spenceraxani/Desktop-Muon-Detector/Pictures/6.jpg

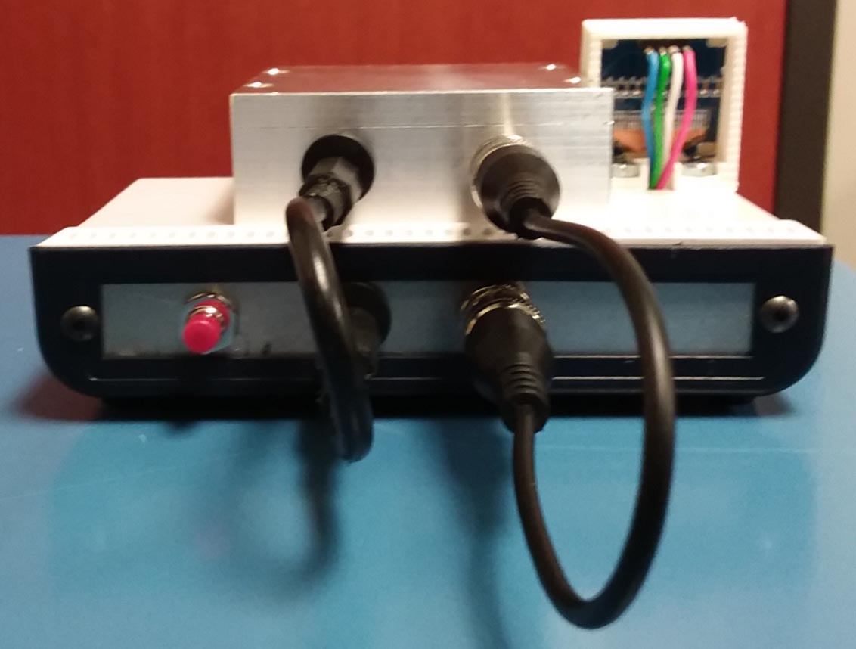
Pictures/6.jpg
