spenceraxani/Desktop-Muon-Detector/Pictures/pcb.jpg

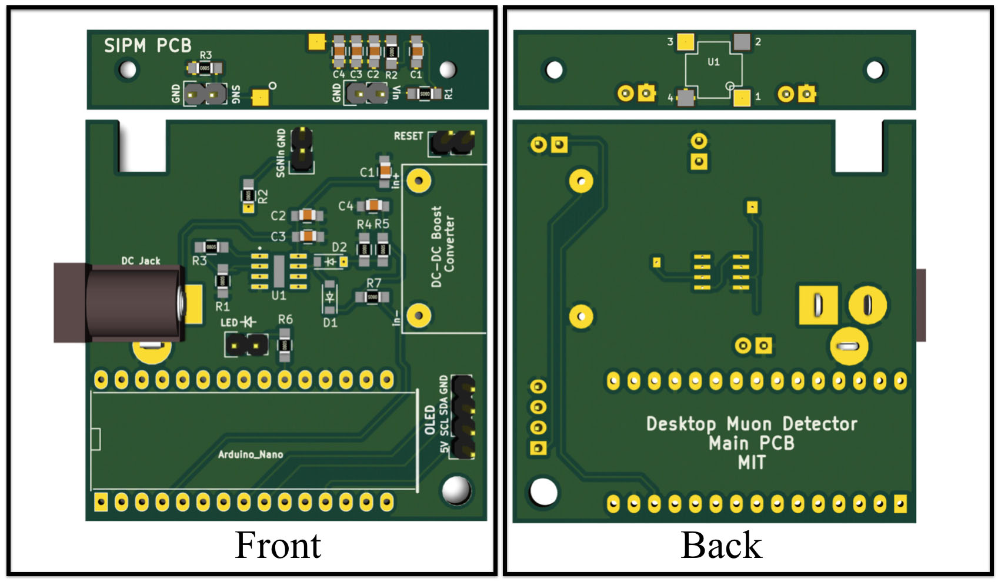
Pictures/pcb.jpg
