spenceraxani/Desktop-Muon-Detector/README.md

# Desktop Muon Detector
-- OUTDATED -- 

Please use the updated detector repository here:

[https://github.com/spenceraxani/CosmicWatch-Desktop-Muon-Detector-v3X]

The supplementary material for the Desktop Muon Detector --
ArXiv article: arXiv:1606.01196 [physics.ed-ph]

-- OUTDATED --
