spenceraxani/Desktop-Muon-Detector/Pictures/1.jpg

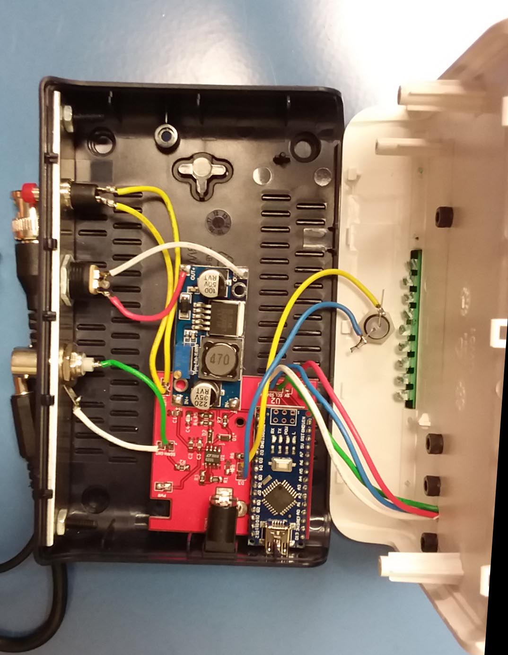
Pictures/1.jpg
