spenceraxani/Desktop-Muon-Detector/Pictures/2.jpg

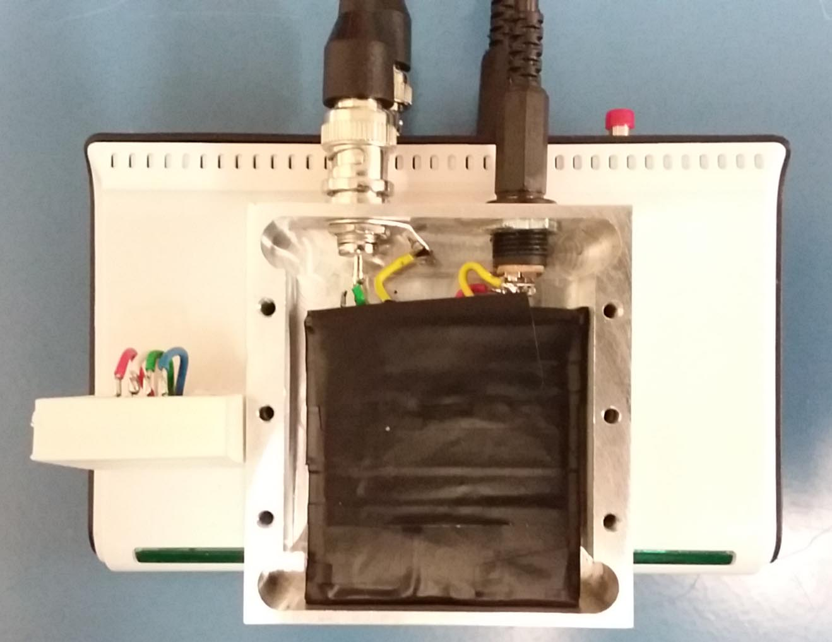
Pictures/2.jpg
