spenceraxani/Desktop-Muon-Detector/Pictures/3.jpg

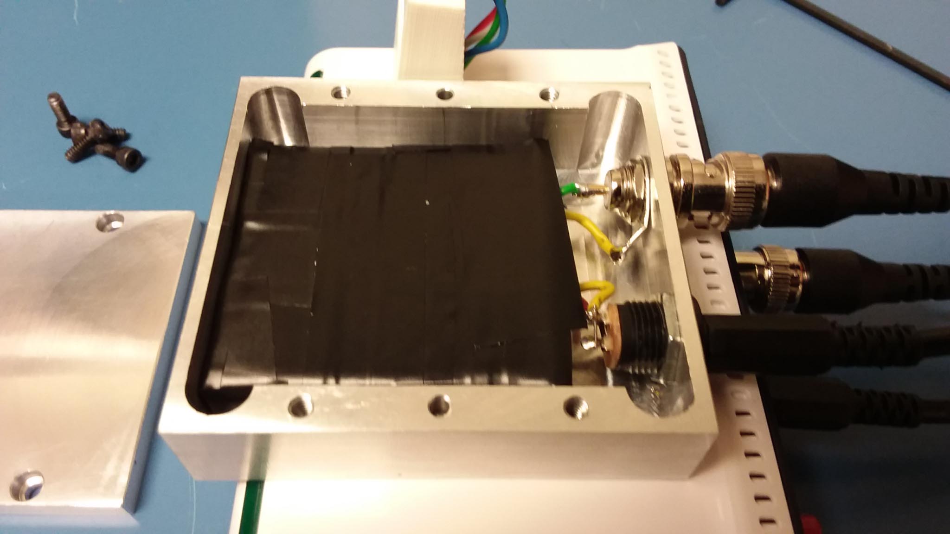
Pictures/3.jpg
