spenceraxani/Desktop-Muon-Detector/Pictures/4.jpg

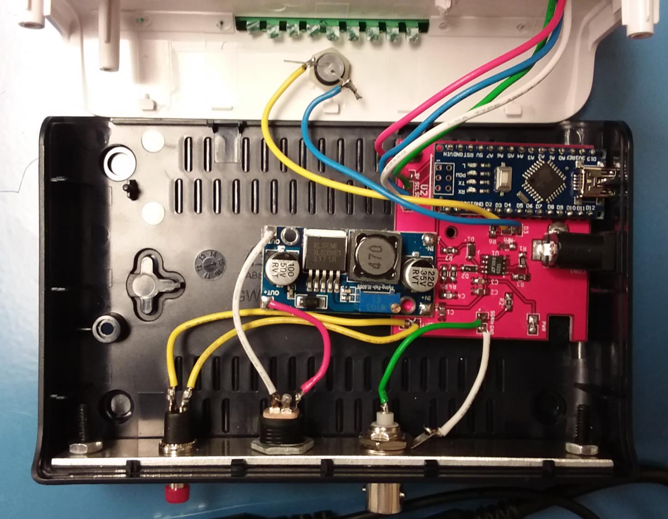
Pictures/4.jpg
