spenceraxani/Desktop-Muon-Detector/Pictures/5.jpg

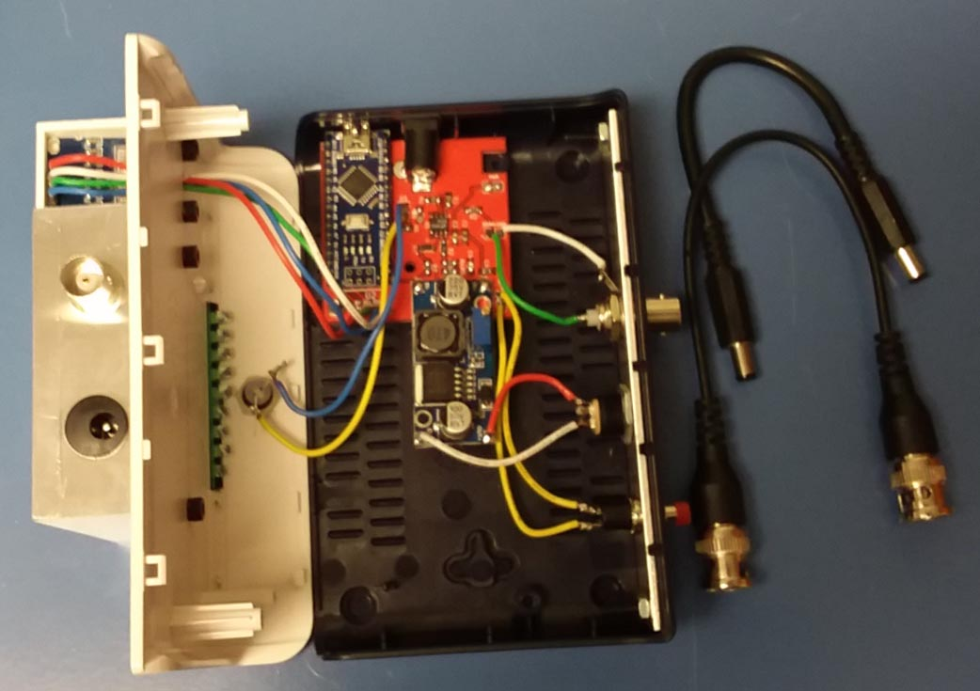
Pictures/5.jpg
