spenceraxani/Desktop-Muon-Detector/Pictures/7.jpg

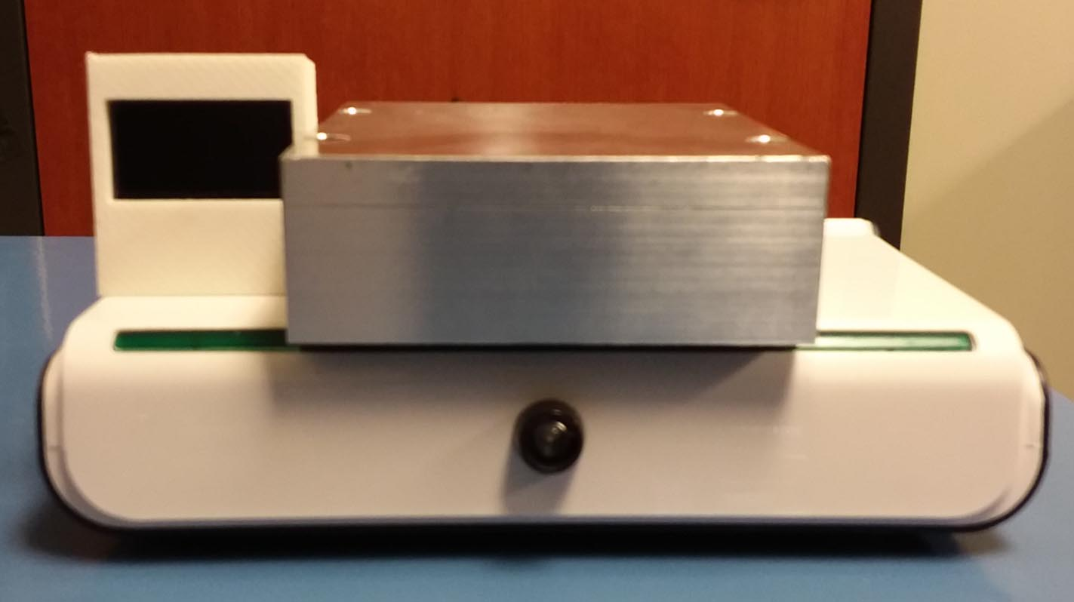
Pictures/7.jpg
