spenceraxani/Desktop-Muon-Detector/Pictures/8.jpg

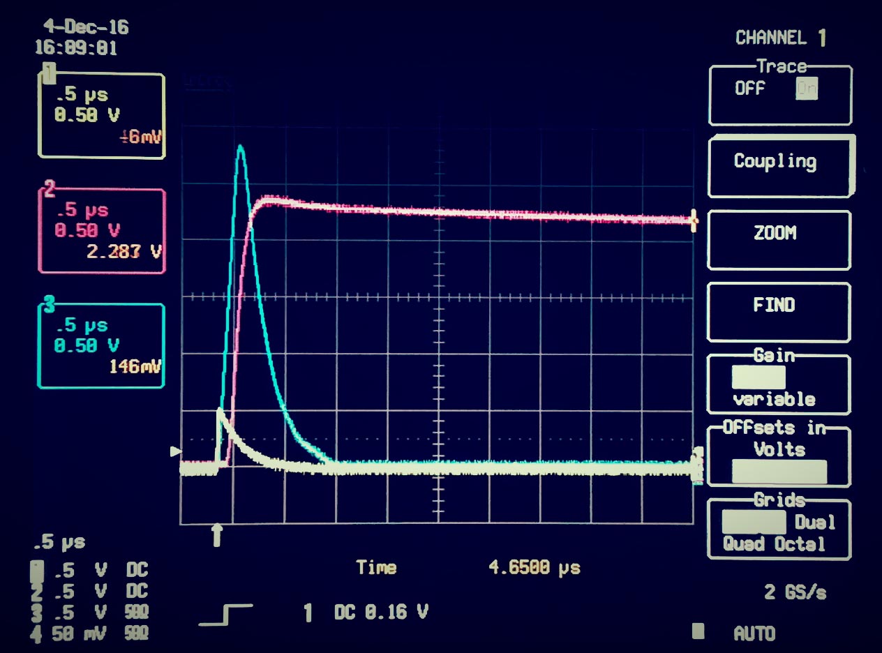
Pictures/8.jpg
