spenceraxani/Desktop-Muon-Detector/Pictures/b.jpg

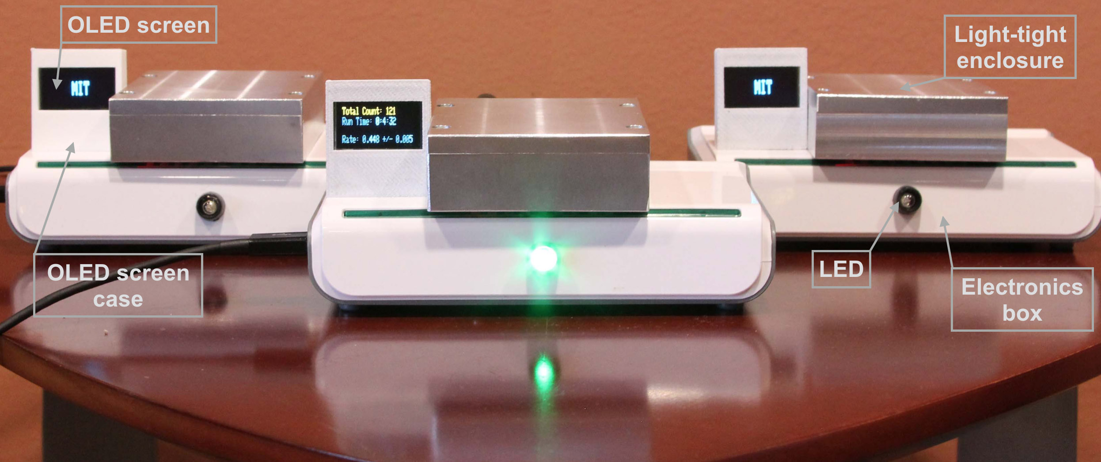
Pictures/b.jpg
