spenceraxani/Desktop-Muon-Detector/Pictures/backplate.jpg

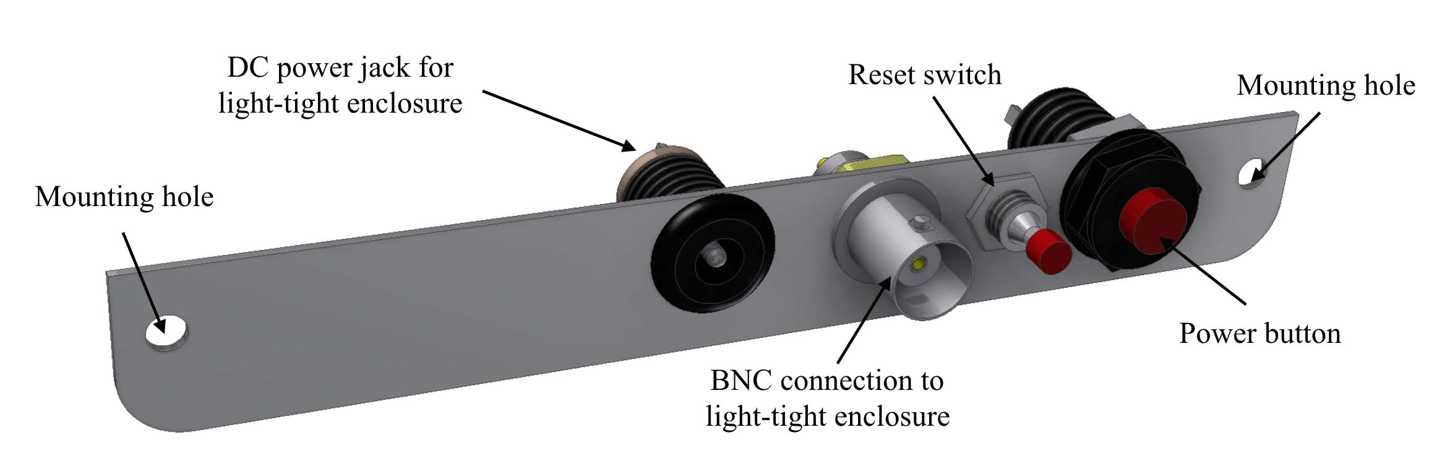
Pictures/backplate.jpg
