spenceraxani/Desktop-Muon-Detector/Pictures/box.jpg

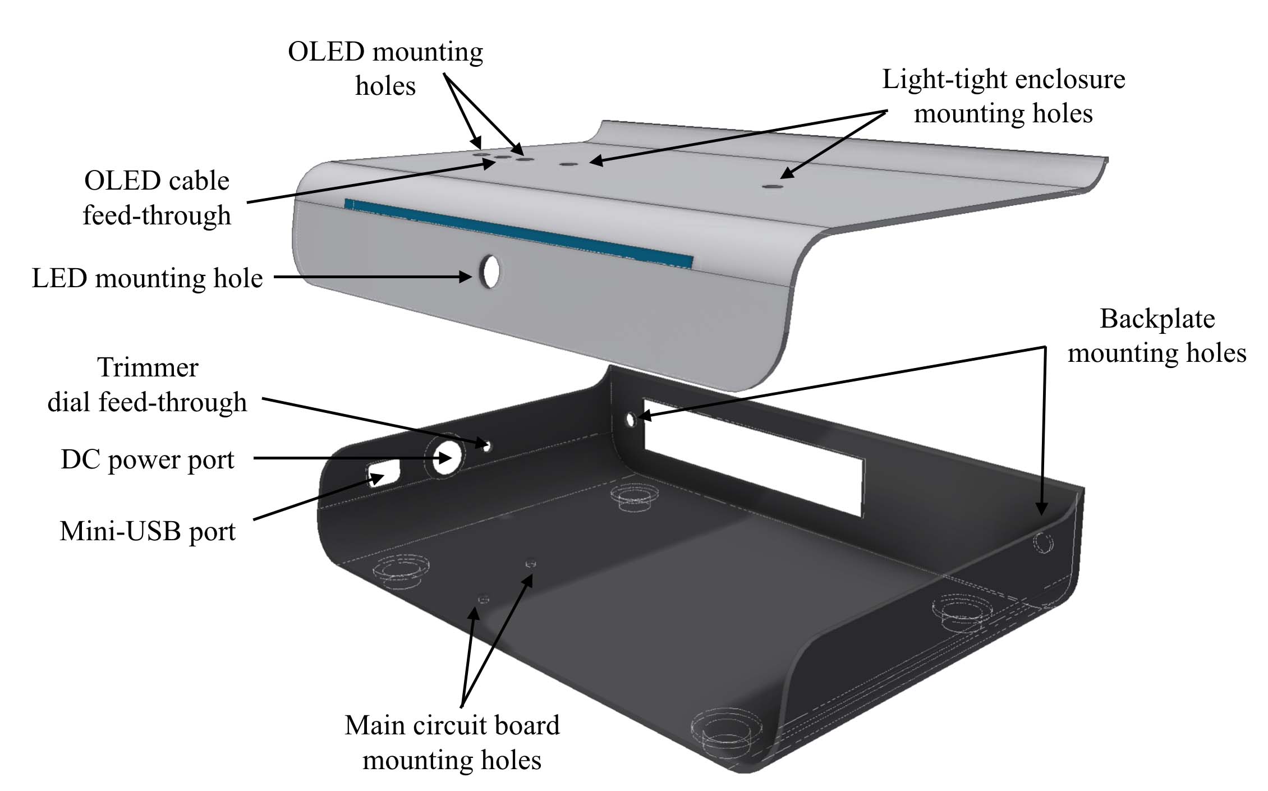
Pictures/box.jpg
