spenceraxani/Desktop-Muon-Detector/Pictures/circuit.png

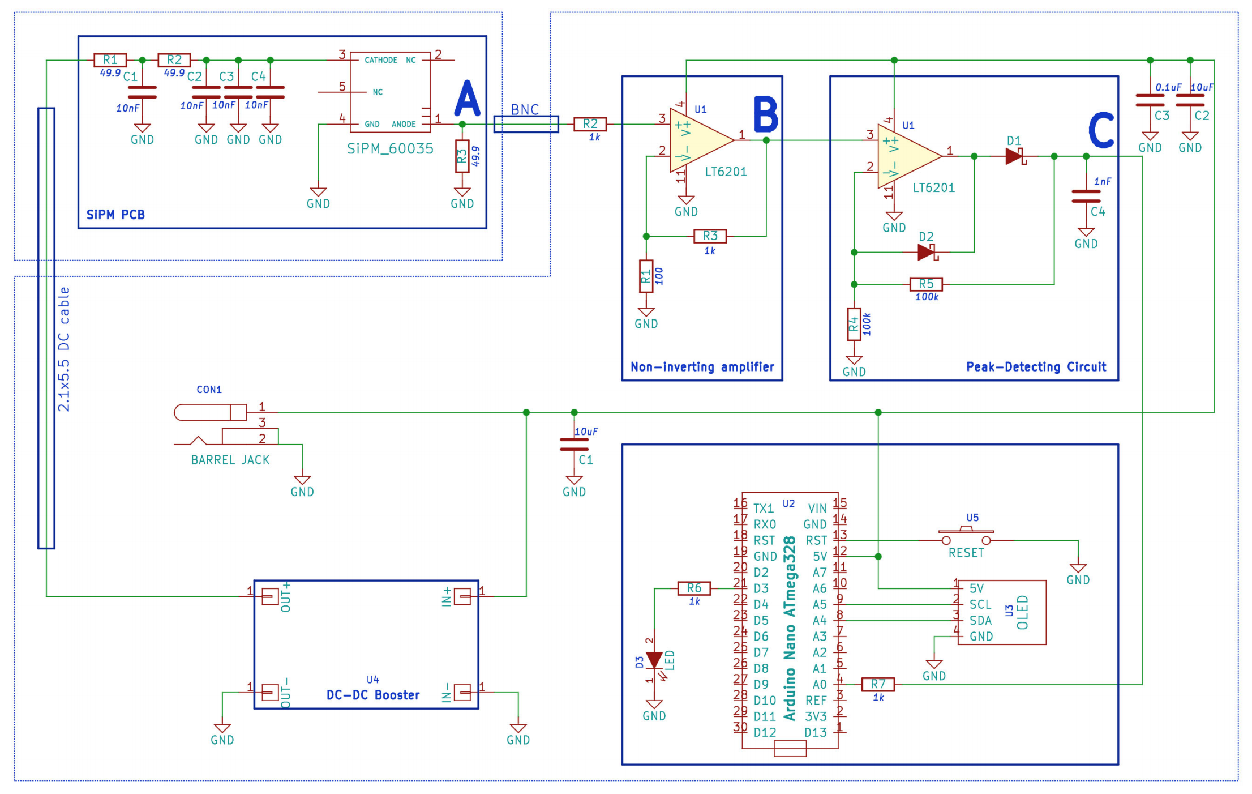
Pictures/circuit.png
