spenceraxani/Desktop-Muon-Detector/Pictures/coincidence.png

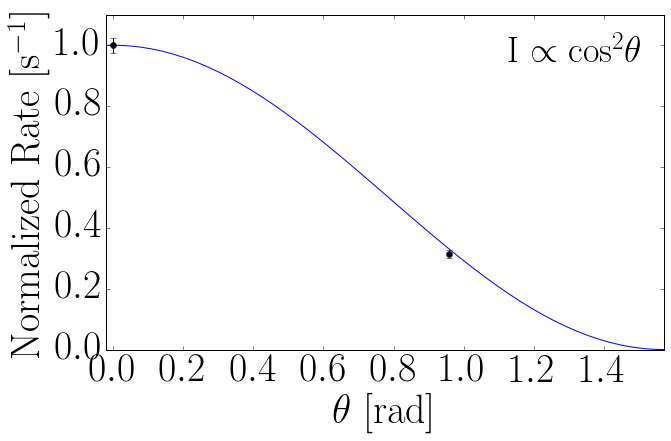
Pictures/coincidence.png
