spenceraxani/Desktop-Muon-Detector/Pictures/data_plot.jpg

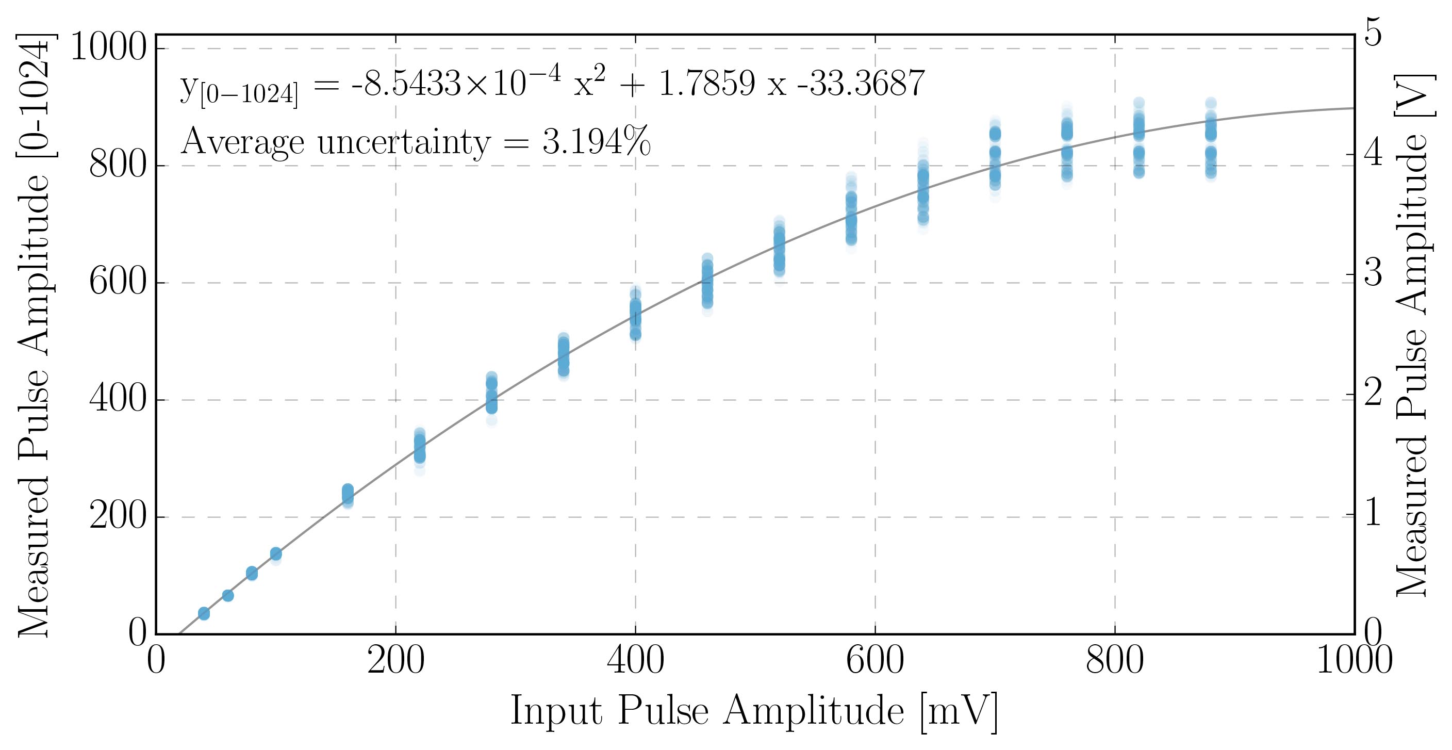
Pictures/data_plot.jpg
