spenceraxani/Desktop-Muon-Detector/Pictures/flight.jpg

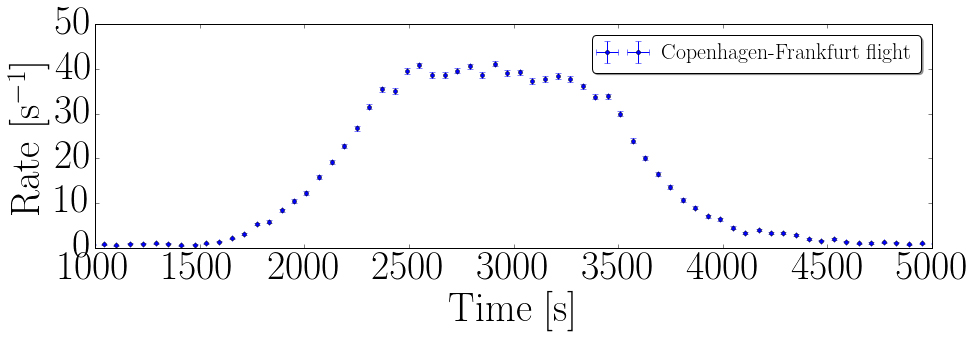
Pictures/flight.jpg
