spenceraxani/Desktop-Muon-Detector/Pictures/full_circuit.jpg

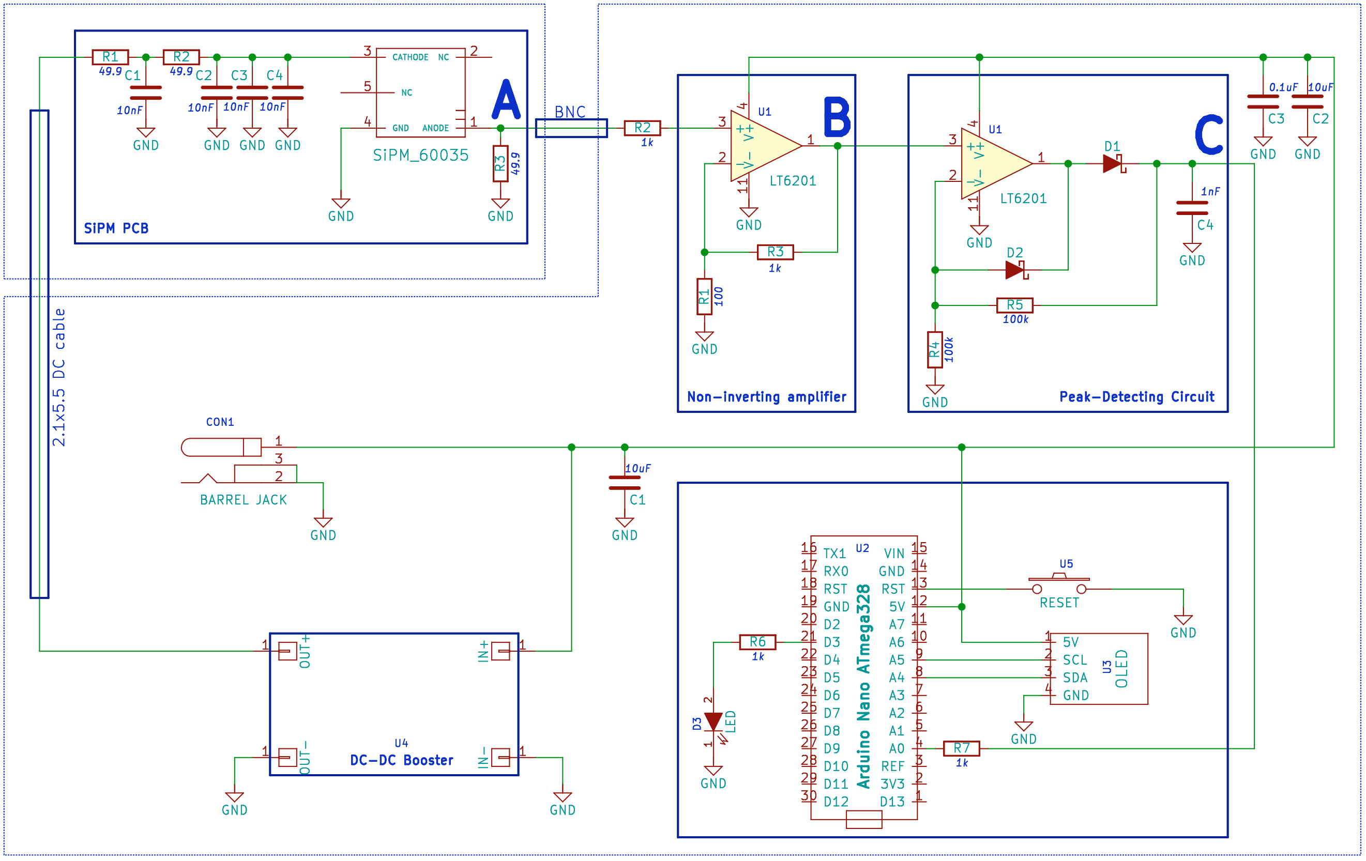
Pictures/full_circuit.jpg
