spenceraxani/Desktop-Muon-Detector/Pictures/light_tight_enclosure.jpg

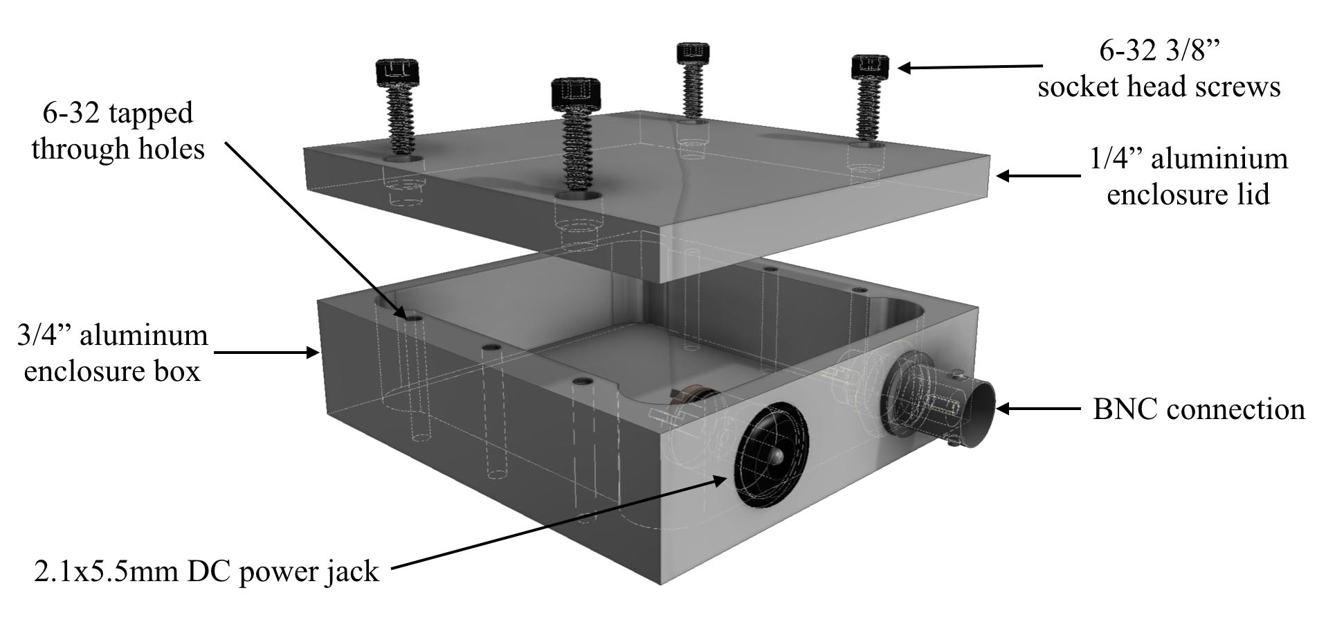
Pictures/light_tight_enclosure.jpg
