spenceraxani/Desktop-Muon-Detector/Pictures/lowPass.jpg

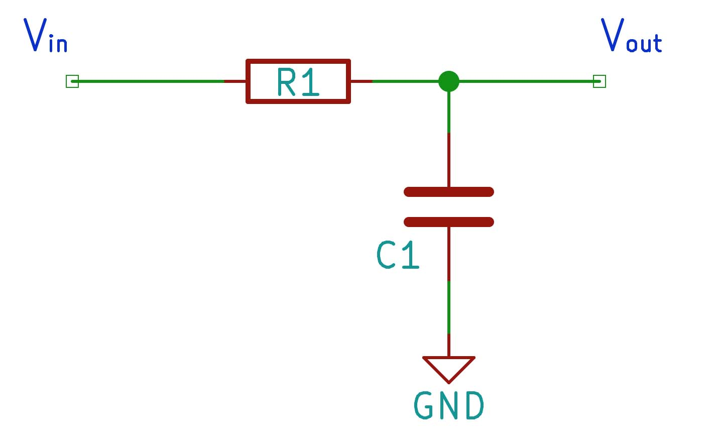
Pictures/lowPass.jpg
