spenceraxani/Desktop-Muon-Detector/Pictures/NIamp.jpg

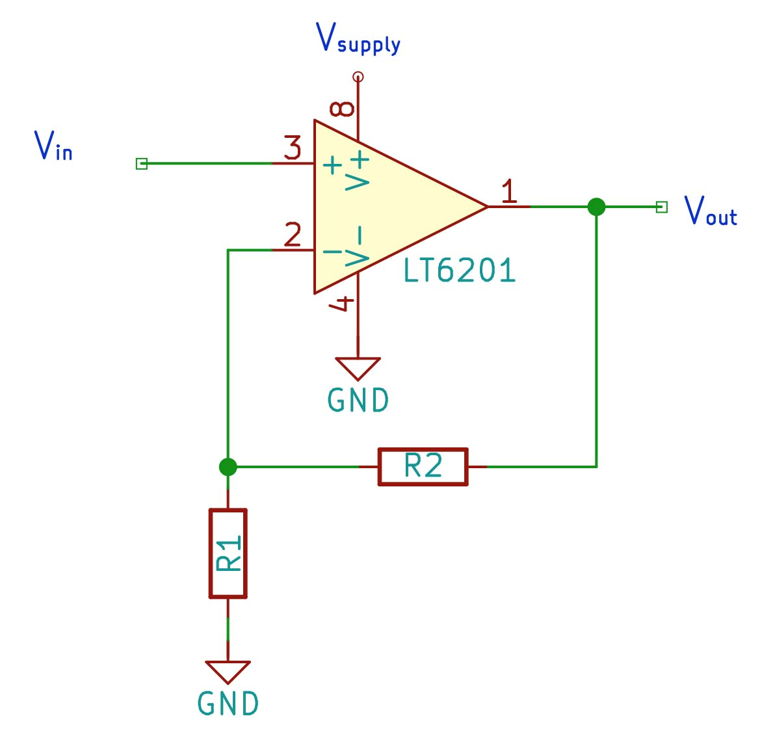
Pictures/NIamp.jpg
