spenceraxani/Desktop-Muon-Detector/Pictures/oled.jpg

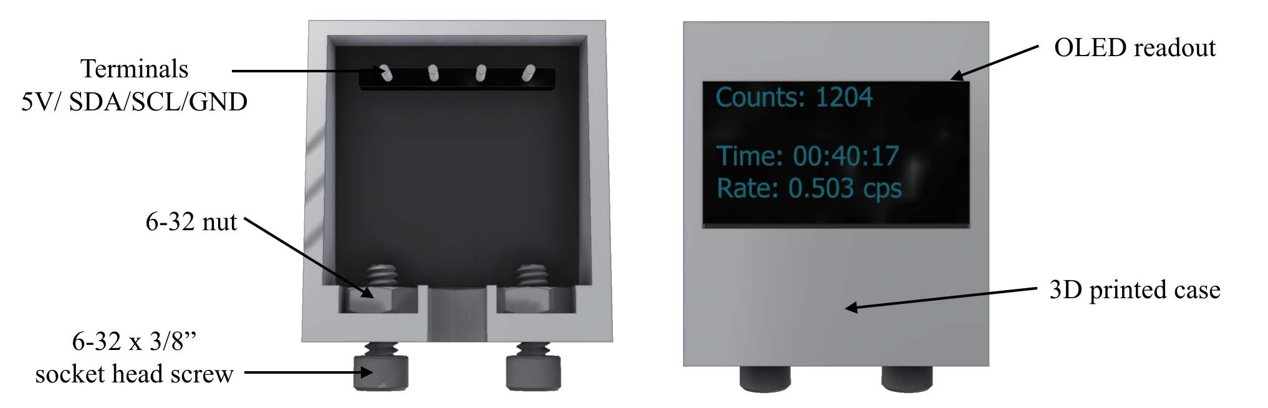
Pictures/oled.jpg
