spenceraxani/Desktop-Muon-Detector/Pictures/osc2.jpg

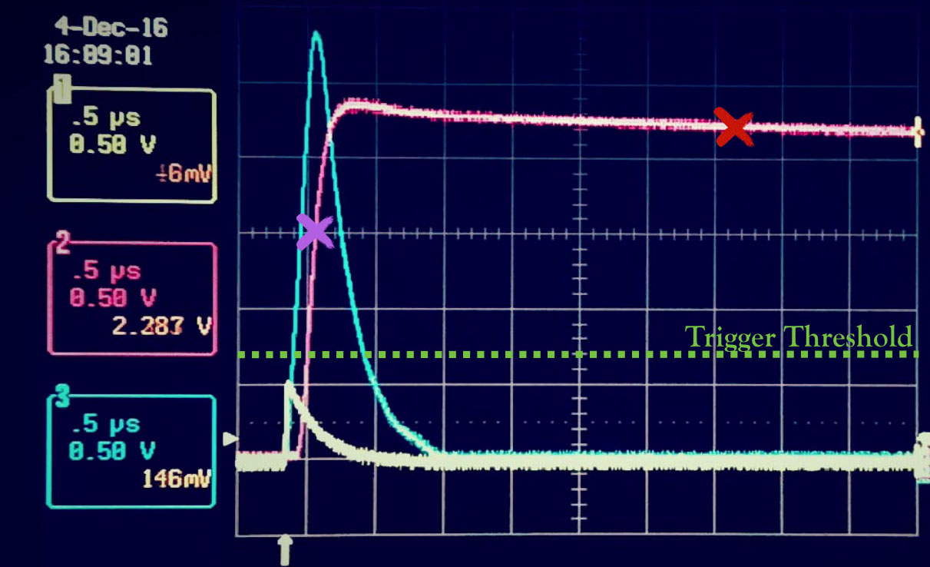
Pictures/osc2.jpg
