spenceraxani/Desktop-Muon-Detector/Pictures/osc.jpg

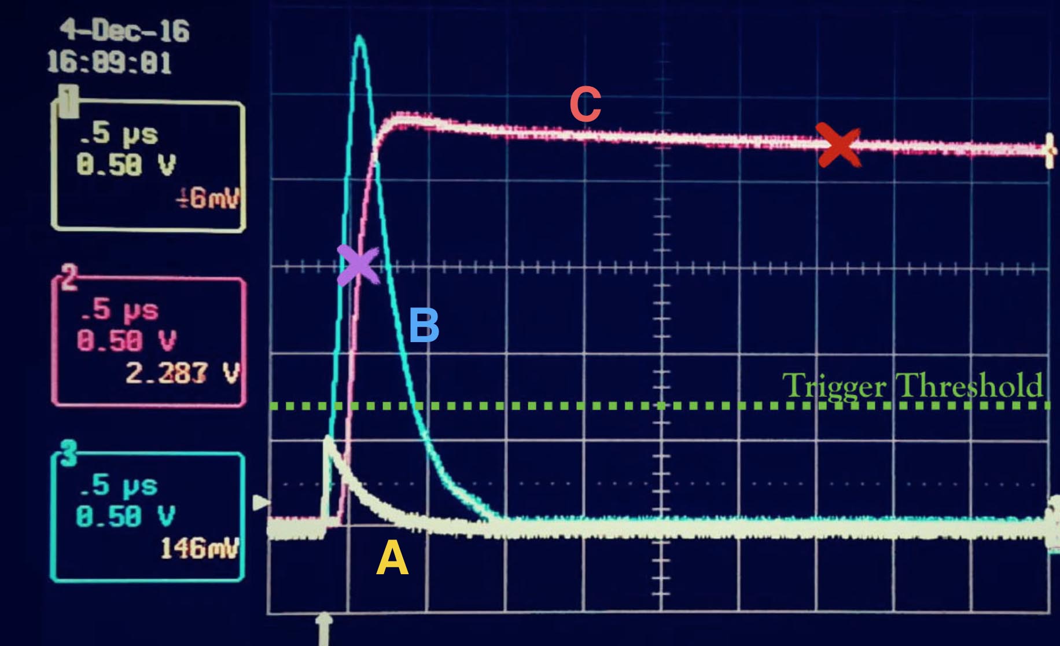
Pictures/osc.jpg
