spenceraxani/Desktop-Muon-Detector/Pictures/pcb.png

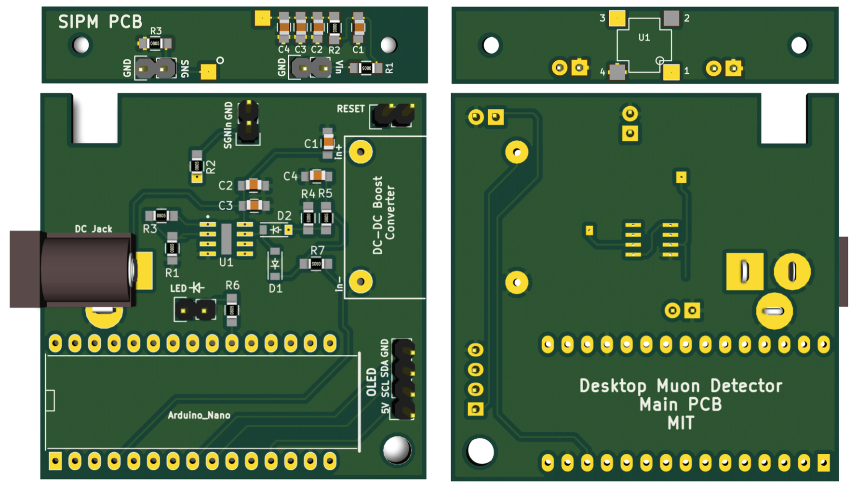
Pictures/pcb.png
