spenceraxani/Desktop-Muon-Detector/Pictures/peakd.jpg

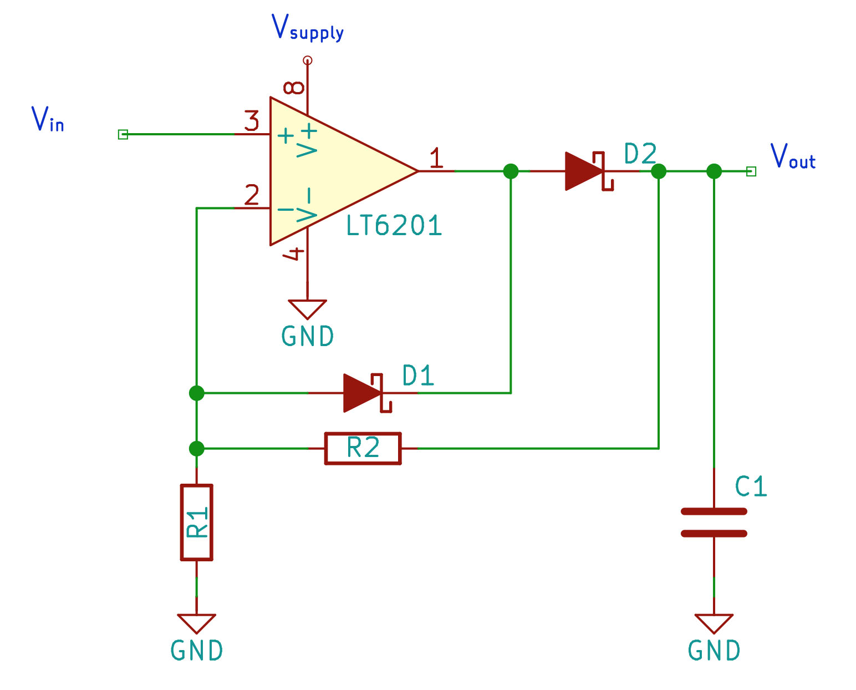
Pictures/peakd.jpg
