spenceraxani/Desktop-Muon-Detector/Pictures/rate.jpg

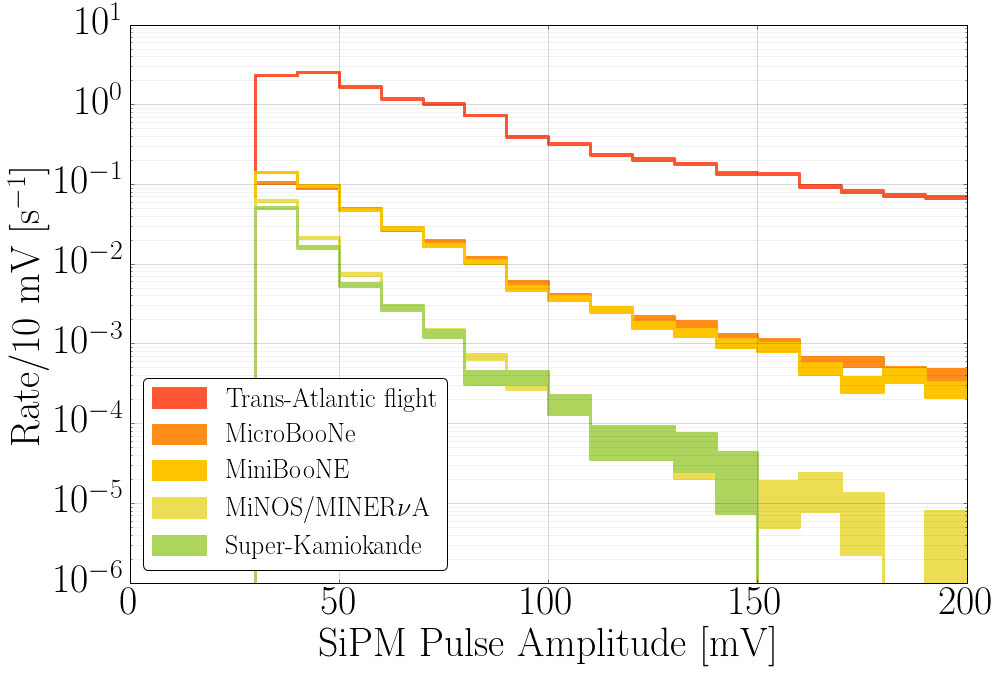
Pictures/rate.jpg
