spenceraxani/Desktop-Muon-Detector/Pictures/SiPM_PS.png

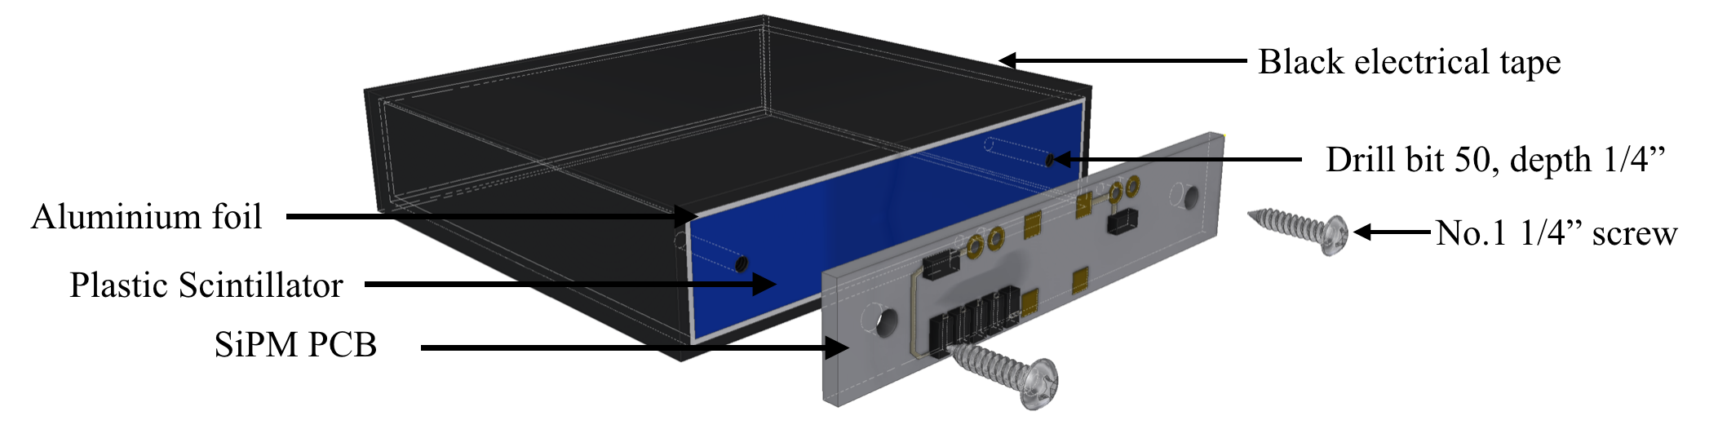
Pictures/SiPM_PS.png
