spenceraxani/Desktop-Muon-Detector/Purchasing_list.xlsx

Component List
No | Description | Required Quantity | Manufacturer | Part Number | Vendor | Purchase Quantity | Unit Price | Price | Website link
Main Components
1 | (SiPM) SensL 60035 smt C-series | 1 | SensL |  | SensL | 100 | 48.00 | 48.00 | http://sensl.com/estore/microfc-60035-smt/
2 | (Electronics Case) Tenda S105 5-Port 10/100Mbps Fast Ethernet Switch + 5V power supply | 1 | Tenda | S105 | Amazon | 1 | 9.16 | 9.16 | http://www.amazon.com/Tenda-S105-Unmanaged-100Mbps-Ethernet/dp/B006KAP55E
3 | (OLED screen) 0.96" Yellow& Blue 128X64 OLED I2C IIC Serial LCD | 1 | DIYmall |  | Amazon | 1 | 3.69 | 3.69 | http://www.ebay.com/itm/0-96-Yellow-Blue-128X64-OLED-I2C-IIC-Serial-LCD-LED-Display-Module-for-Arduino-B3:K45-jhUK-o~
4 | 6-32x3/8" socket head screws | 10 | McMaster Carr |  | McMaster Carr | 100 | 0.08 | 0.84 | http://www.mcmaster.com/#socket-head-cap-screws/=12e48qv
5 | 6-32 nuts | 2 | McMaster Carr |  | McMaster Carr | 100 | 0.05 | 0.10 | http://www.mcmaster.com/#hex-nuts/=12e49wo
6 | BNC Female Nut Bulkhead Solder RF Connector | 2 | Bluecell | 5316345 | Amazon | 1 | 1.47 | 2.94 | http://www.amazon.com/Bluecell-Female-Bulkhead-Connector-Adapters/dp/B00QPWBNXU
7 | Reset switch | 1 | URBEST |  | Amazon | 10 | 0.70 | 0.70 | http://www.amazon.com/URBEST%C2%AE10-Round-Momentary-Botton-Switch/dp/B00OJZPMD2?redirect=true
8 | Female 5.5mmx2.1mm DC Power Jack | 1 |  |  | Amazon | 50 | 0.11 | 0.11 | http://www.amazon.com/50PCS-5-5mmx2-1mm-3Pins-Mounting-Female/dp/B00MJVIFS2?redirect=true
9 | 2.1x5.5mm DC Power Jack Socket | 2 |  |  | Amazon | 50 | 0.28 | 0.55 | http://www.amazon.com/50Pcs-2-1x5-5mm-Socket-Mounting-Earphones/dp/B00H8S4H9W?redirect=true
10 | USB 2.0 Type A to Mini-B Cable (often supplied with Arduino) | 1 |  |  | ebay | 3 | 0.77 | 0.77 | http://www.ebay.com/itm/New-Black-USB-2-0-A-Male-to-Mini-5-Pin-B-Data-Charging-Cable-Cord-Adapter-/191690598969
11 | SiPM PCB (manufacturing cost) | 1 | Elecrow.com | SiPM_PCB.zip | Elecrow | 10 | 0.99 | 0.99 | http://www.elecrow.com/services-c-73.html
12 | Main PCB (manufacturing cost) | 1 | Elecrow.com | Main_PCB.zip | Elecrow | 10 | 0.99 | 0.99 | http://www.elecrow.com/services-c-73.html
13 | 3/4" aluminium plate (2.75"x3.0"x3/4") | 1 | McMaster Carr |  | McMaster Carr | 3"x24"x3/4" | 4.52 | 4.52 | http://www.mcmaster.com/#standard-aluminum-plates/=13kanb3
14 | 1/4" aluminium plate (~2.75"x3.00"x1/4") | 1 | McMaster Carr |  | McMaster Carr | 3"x24"x1/4" | 2.36 | 2.36 | http://www.mcmaster.com/#standard-aluminum-plates/=13kan4b
15 | 3D-printed screen protector, 0.5"^3 material | 1 |  |  |  |  | 5.00 | 5.00
Electronic Components
16 | Dual Op-amp RRIO 165 MHz | 1 | Linear Technology | LT6201CS8#PBF-ND | Linear Technology | 1 | 4.50 | 4.50 | http://www.linear.com/product/LT6201
17 | Arduino Nano (often will come with a mini-usb cable) | 1 |  |  | ebay | 1 | 1.89 | 1.89 | http://www.ebay.com/itm/Mini-USB-Nano-V3-0-ATmega328-CH340G-5V-16M-Micro-controller-board-for-Arduino-/271675478151
18 | DC-DC Boost Converter, 400kHz switching frequency | 1 | Yankee Electronics |  | ebay | 1.35 | 1.35 | 1.35 | http://www.ebay.com/itm/DC-DC-Adjustable-Step-up-boost-Power-Converter-Module-XL6009-Replace-LM2577-/371054648639
19 | 40V Schottky diode | 2 | digikey | MBR0540CT-ND | Digikey | 100 | 0.14 | 0.28 | http://www.digikey.com/scripts/DkSearch/dksus.dll?Detail&itemSeq=202968032&uq=636054679578129175
20 | (0805) 1K 1% 1/8W | 4 | digikey | 311-1.00KCRCT-ND (http://www.digikey.com/scripts/DkSearch/dksus.dll?Detail&itemSeq=202966236&uq=636054677712469041) | Digikey | 100 | 0.01 | 0.03 | http://www.digikey.com/product-detail/en/stackpole-electronics-inc/RMCF0805JT10K0/RMCF0805JT10K0CT-ND/1942577
21 | (0805)100 1% 1/8W | 1 | digikey | 311-100CRDKR-ND (https://www.digikey.com/product-detail/en/yageo/RC0805FR-07100RL/311-100CRDKR-ND/733437) | DigiKey | 100 | 0.01 | 0.01 | https://www.digikey.com/product-detail/en/yageo/RC0805FR-07100RL/311-100CRDKR-ND/733437
22 | (0805) 100K 1% 1/8W | 2 | digikey | 311-100KCRCT-ND | Digikey | 100 | 0.01 | 0.02 | http://www.digikey.com/scripts/DkSearch/dksus.dll?Detail&itemSeq=202966511&uq=636054679578099184
23 | (0805) 1nF 50V SMT cap | 1 | digikey | 399-1147-1-ND | Digikey | 100.00 | 0.02 | 0.02 | http://www.digikey.com/product-detail/en/kemet/C0805C102K5RACTU/399-1147-1-ND/411422
24 | (0805) 10uF CER 35V capacitor | 2 | digikey | 490-9964-1-ND (http://www.digikey.com/product-detail/en/murata-electronics-north-america/GRM319R6YA106KA12D/490-9964-1-ND/5026458) | Digikey | 25 | 0.14 | 0.28 | http://www.digikey.com/product-detail/en/murata-electronics-north-america/GRM319R6YA106KA12D/490-9964-1-ND/5026458
25 | (0805) 10nF 50V SMT cap | 4 | digikey | 311-1136-1-ND | amazon | 100 | 0.01 | 0.06 | http://www.digikey.com/scripts/DkSearch/dksus.dll?Detail&itemSeq=202967660&uq=636054697441185813
26 | (0805) 49.9 Ohm 1% 1/8W | 3 | digikey | P49.9CCT-ND | Digikey | 100 | 0.02 | 0.05 | http://www.digikey.com/product-detail/en/panasonic-electronic-components/ERJ-6ENF49R9V/P49.9CCT-ND/118581
27 | (0805) 0.1uF 50V SMT cap | 1 | digikey | 1276-1007-1-ND | Digikey | 100.00 | 0.01 | 0.01 | http://www.digikey.com/product-detail/en/samsung-electro-mechanics-america-inc/CL21F104ZBCNNNC/1276-1007-1-ND/3889093
 |  |  |  |  |  |  | Total: | 89.22 | USD
Other Potential Components/Tools
33 | ~22 gauge wire
34 | solder
35 | soldering iron
36 | fine tip tweezers
37 | Mill+milling tools
40 | BNC cable (may have to make your own)
