spenceraxani/Desktop-Muon-Detector/PCB/SMT_reference.xlsx

Main PCB
Component | value | Description | Link
R1 | 100 | 0805 1% 1/8W | 311-100CRCT-ND (http://www.digikey.com/product-detail/en/yageo/RC0805FR-07100RL/311-100CRCT-ND/730490) | Digikey Part: 311-100CRCT-ND
R2 | 1k | 0805 1% 1/8W | 311-1.00KCRCT-ND (http://www.digikey.com/product-detail/en/yageo/RC0805FR-071KL/311-1.00KCRCT-ND/730391) | Digikey Part: 311-1.00KCRCT-ND
R3 | 1k | 0805 1% 1/8W | 311-1.00KCRCT-ND (http://www.digikey.com/product-detail/en/yageo/RC0805FR-071KL/311-1.00KCRCT-ND/730391) | Digikey Part: 311-1.00KCRCT-ND
R4 | 100k | 0805 1% 1/8W | 311-100KCRCT-ND (http://www.digikey.com/product-detail/en/yageo/RC0805FR-07100KL/311-100KCRCT-ND/730491) | Digikey Part: 311-100KCRCT-ND
R5 | 100k | 0805 1% 1/8W | 311-100KCRCT-ND (http://www.digikey.com/product-detail/en/yageo/RC0805FR-07100KL/311-100KCRCT-ND/730491) | Digikey Part: 311-100KCRCT-ND
R6 | 1k | 0805 1% 1/8W | 311-1.00KCRCT-ND (http://www.digikey.com/product-detail/en/yageo/RC0805FR-071KL/311-1.00KCRCT-ND/730391) | Digikey Part: 311-1.00KCRCT-ND
R7 | 1k | 0805 1% 1/8W | 311-1.00KCRCT-ND (http://www.digikey.com/product-detail/en/yageo/RC0805FR-071KL/311-1.00KCRCT-ND/730391) | Digikey Part: 311-1.00KCRCT-ND
C1 | 10uF | CER 35V 0805 | 490-9964-1-ND (http://www.digikey.com/scripts/DkSearch/dksus.dll?Detail&itemSeq=203015473&uq=636054677712509029) | Digikey Part: 490-9964-1-ND
C2 | 10uF | CER 35V 0805 | 490-9964-1-ND (http://www.digikey.com/scripts/DkSearch/dksus.dll?Detail&itemSeq=203015473&uq=636054677712509029) | Digikey Part: 490-9964-1-ND
C3 | 0.1uF | CER 50V Y5V 0805 | 1276-1007-1-ND (http://www.digikey.com/scripts/DkSearch/dksus.dll?Detail&itemSeq=202967692&uq=636054679578129175) | Digikey Part: 1276-1007-1-ND
C4 | 1nF | CER 50V X7R 0805 | 399-1147-1-ND (http://www.digikey.com/scripts/DkSearch/dksus.dll?Detail&itemSeq=202967660&uq=636054679578119178) | Digikey Part: 399-1147-1-ND
D1 |  | Schottky 40V 500MA | MBR0540CT-ND (https://www.digikey.com/products/en?keywords=MBR0540CT-ND) | Digikey Part: 490-9964-1-ND
D2 |  | Schottky 40V 500MA | MBR0540CT-ND (https://www.digikey.com/products/en?keywords=MBR0540CT-ND) | Digikey Part: 490-9964-1-ND
D3 | 5mm | LED | ArduinoLink (https://www.amazon.com/s?url=search-alias%3Daps&field-keywords=led+5mm&rh=i%3Aaps%2Ck%3Aled+5mm)
U1 | 165 MHz | Dual Op-Amp LT6201CS8 | LT6201CS8#PBF-ND (http://www.digikey.com/product-detail/en/linear-technology/LT6201CS8-PBF/LT6201CS8-PBF-ND/888717)
U2 | 16 MHz | 16 MHz Arduino Nano | ArduinoLink (https://www.arduino.cc/en/Main/ArduinoBoardNano) | Check Ebay
U3 |  | OLED 0.96" screen | AmazonLink (https://www.amazon.com/Diymall%C2%AE-Yellow-Serial-Arduino-Display/dp/B00O2LLT30) | Check Ebay
U4 | 30V | DC-DC Boost Converter | AmazonLink (https://www.amazon.com/Hilitchi-LM2596-Converter-XL6009-1-23V-30V/dp/B018R39CSM?s=pc) | Check Ebay
U5 | RESET | Reset switch | AmazonLink (https://www.amazon.com/URBEST-Momentary-Button-Switch-Pieces/dp/B00OJZPMD2)
CON1 |  | Barrel Jack connector | AmazonLink (https://www.amazon.com/TOOGOO-10pcs-Power-Socket-Barrel-Type/dp/B00LHKYDXM?s=pc)
SiPM PCB
Component | value | Discription | Link | Comment
R1 | 49.9 | 0805 1% 1/8W | 311-49.9CRCT-ND (http://www.digikey.com/product-detail/en/yageo/RC0805FR-0749R9L/311-49.9CRCT-ND/730931) | Digikey Part: 311-49.9CRCT-ND
R2 | 49.9 | 0805 1% 1/8W | 311-49.9CRCT-ND (http://www.digikey.com/product-detail/en/yageo/RC0805FR-0749R9L/311-49.9CRCT-ND/730931) | Digikey Part: 311-49.9CRCT-ND
R3 | 49.9 | 0805 1% 1/8W | 311-49.9CRCT-ND (http://www.digikey.com/product-detail/en/yageo/RC0805FR-0749R9L/311-49.9CRCT-ND/730931) | Digikey Part: 311-49.9CRCT-ND
C1 | 10 nF | 50V X7R 0805 | 311-1136-1-ND (http://www.digikey.com/scripts/DkSearch/dksus.dll?Detail&itemSeq=202967660&uq=636054697441185813) | Digikey Part: 311-1136-1-ND
C2 | 10 nF | 50V X7R 0805 | 311-1136-1-ND (http://www.digikey.com/scripts/DkSearch/dksus.dll?Detail&itemSeq=202967660&uq=636054697441185813) | Digikey Part: 311-1136-1-ND
C3 | 10 nF | 50V X7R 0805 | 311-1136-1-ND (http://www.digikey.com/scripts/DkSearch/dksus.dll?Detail&itemSeq=202967660&uq=636054697441185813) | Digikey Part: 311-1136-1-ND
C4 | 10 nF | 50V X7R 0805 | 311-1136-1-ND (http://www.digikey.com/scripts/DkSearch/dksus.dll?Detail&itemSeq=202967660&uq=636054697441185813) | Digikey Part: 311-1136-1-ND
U1 |  | SiPM MicroFC-60035-SMT | SENSL (http://sensl.com/estore/microfc-60035-smt/)
