spenceraxani/Desktop-Muon-Detector/Machining/box_CNC.dxf

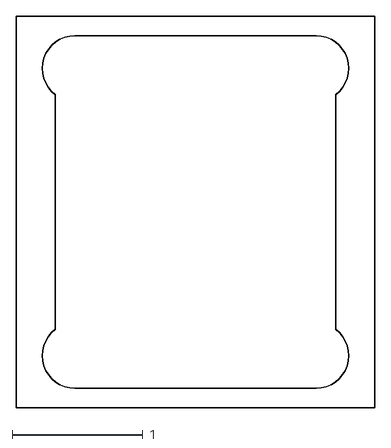
[picture p28: CAD file, 2016-12-18]
Machining/box_CNC.dxf
2.75 x 3.00
