spenceraxani/Desktop-Muon-Detector/Machining/lid.stp

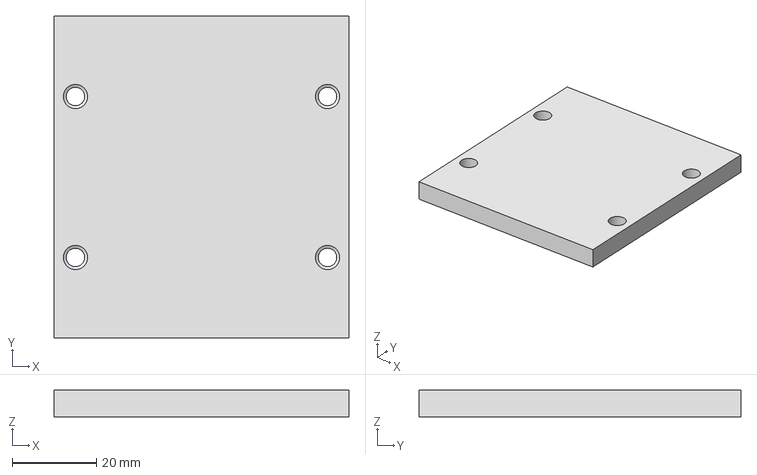
[picture p29: CAD file, 2016-12-18]
Machining/lid.stp
69.8 x 76.2 x 6.35 mm
