spenceraxani/Desktop-Muon-Detector/Machining/OLED_case.stp

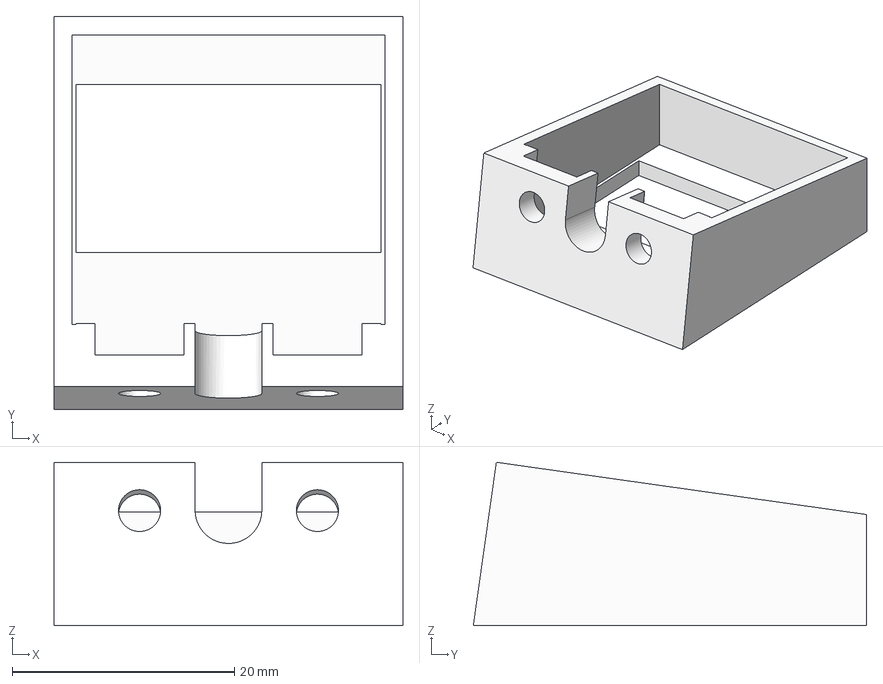
[picture p30: CAD file, 2016-12-18]
Machining/OLED_case.stp
31.4 x 35.4 x 14.7 mm
