spenceraxani/Desktop-Muon-Detector/Machining/box.stp

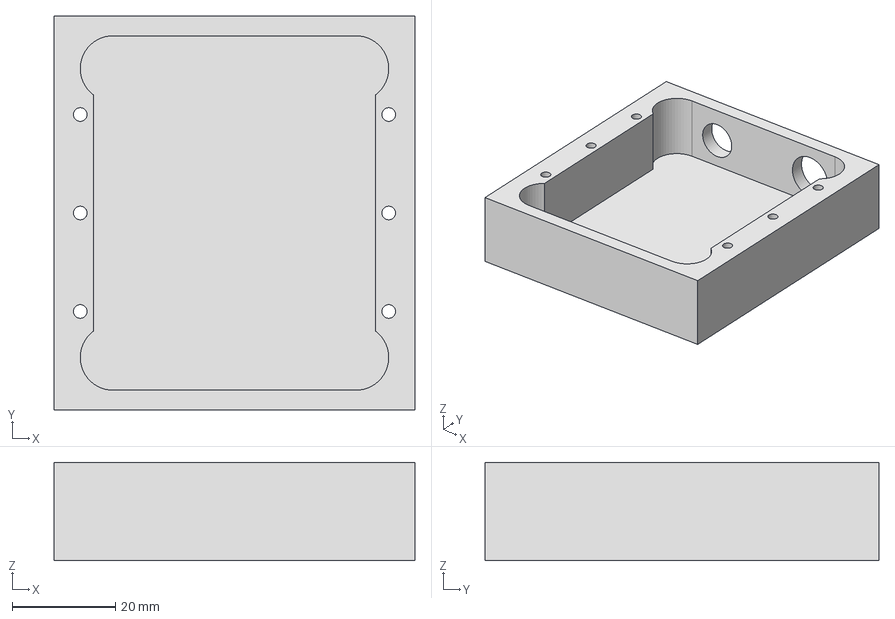
[picture p31: CAD file, 2016-12-18]
Machining/box.stp
69.8 x 76.2 x 19.0 mm
