spenceraxani/Desktop-Muon-Detector/Pictures/assembly.jpg

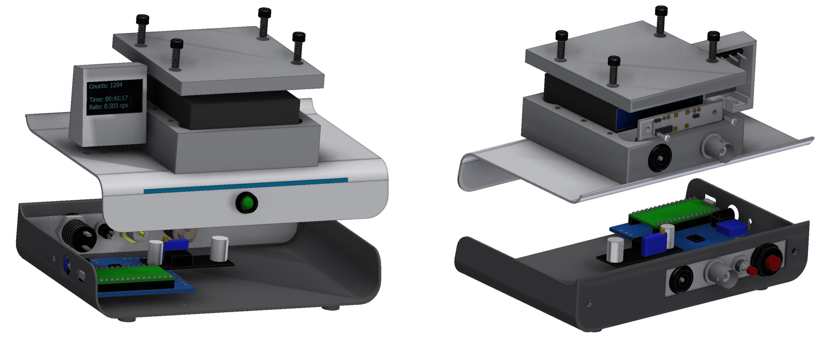
Pictures/assembly.jpg
