spenceraxani/Desktop-Muon-Detector/Pictures/wiring_diagram.jpg

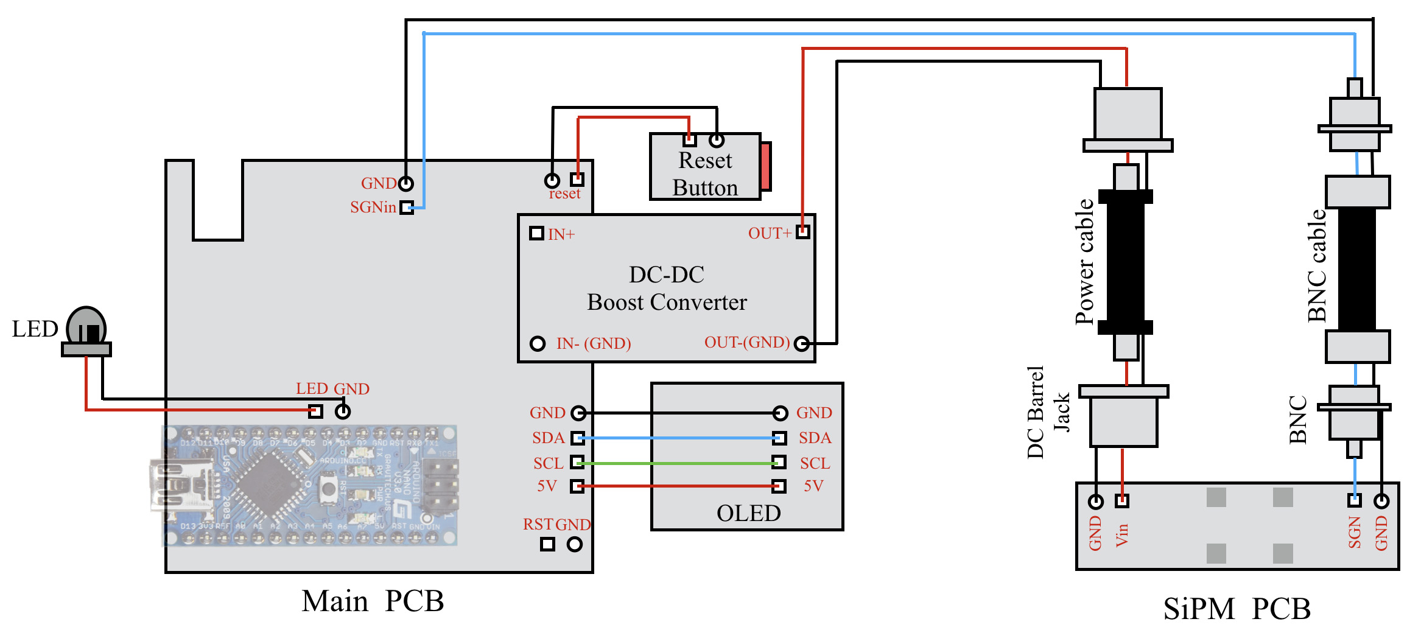
Pictures/wiring_diagram.jpg
