spenceraxani/Desktop-Muon-Detector/Arduino/OzOLED/OzOLED.h

/*
  OzOLED.h - 0.96' I2C 128x64 OLED Driver Library
  2014 Copyright (c) OscarLiang.net  All right reserved.
 
  Author: Oscar Liang
  
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
*/

#ifndef OzOLED_data_H
#define OzOLED_data_H

#include <Arduino.h>

#define OzOLED_Max_X					128	//128 Pixels
#define OzOLED_Max_Y					64	//64  Pixels

#define OLED_ADDRESS					0x3C
#define I2C_400KHZ						1	// 0 to use default 100Khz, 1 for 400Khz

// registers
#define OzOLED_COMMAND_MODE				0x80
#define OzOLED_DATA_MODE				0x40

// commands
#define OzOLED_CMD_DISPLAY_OFF			0xAE
#define OzOLED_CMD_DISPLAY_ON			0xAF
#define OzOLED_CMD_NORMAL_DISPLAY		0xA6
#define OzOLED_CMD_INVERSE_DISPLAY		0xA7
#define OzOLED_CMD_SET_BRIGHTNESS		0x81

#define OzOLED_RIGHT_SCROLL				0x26
#define OzOLED_LEFT_SCROLL				0x27
#define OzOLED_SET_VERTICAL_SCROLL_AREA 0xA3
#define OzOLED_VERTICAL_RIGHT_SCROLL	0x29
#define OzOLED_VERTICAL_LEFT_SCROLL		0x2A
#define OzOLED_CMD_ACTIVATE_SCROLL		0x2F
#define OzOLED_CMD_DEACTIVATE_SCROLL	0x2E

#define HORIZONTAL_ADDRESSING	0x00
#define PAGE_ADDRESSING			0x02

#define Scroll_Left				0x00
#define Scroll_Right			0x01
#define Scroll_Up				0x02
#define Scroll_Down				0x03

#define Scroll_2Frames			0x07
#define Scroll_3Frames			0x04
#define Scroll_4Frames			0x05
#define Scroll_5Frames			0x00
#define Scroll_25Frames			0x06
#define Scroll_64Frames			0x01
#define Scroll_128Frames		0x02
#define Scroll_256Frames		0x03


class OzOLED {

public:

	byte addressingMode;

	void sendCommand(byte command);
	void sendData(byte Data);

	void printChar(char c, byte X=255, byte Y=255);
	void printString(const char *String, byte X=255, byte Y=255, byte numChar=255);
	byte printNumber(long n, byte X=255, byte Y=255);
	byte printNumber(float float_num, byte prec=6, byte Y=255, byte numChar=255);
	void printBigNumber(const char *number, byte column=0, byte page=0, byte numChar=255); 
	void drawBitmap(const byte *bitmaparray, byte X, byte Y, byte width, byte height);

	void init();
	
	void setCursorXY(byte Column, byte Row);
	void clearDisplay();
	//void clearPage(byte page);
	
	void setNormalDisplay();
	void setInverseDisplay();
	void setPowerOff();
	void setPowerOn();
	void setPageMode();
	void setHorizontalMode();
	void setBrightness(byte Brightness);
	
	void scrollRight(byte start, byte end, byte speed);
	void scrollLeft(byte start, byte end, byte speed);
	void scrollDiagRight();
	void scrollDiagLeft();
	void setActivateScroll(byte direction, byte startPage, byte endPage, byte scrollSpeed);
	void setDeactivateScroll();

};

extern OzOLED OzOled;  // OzOLED object 

#endif
