spenceraxani/Desktop-Muon-Detector/Arduino/OzOLED/examples/OLED_Bitmap_Inverse_Display/OLED_Bitmap_Inverse_Display.ino

#include <Wire.h>
#include <OzOLED.h>


const byte OscarLogo[] PROGMEM ={

0x00, 0x00, 0x00, 0x00, 0x00, 0x00, 0x00, 0x00, 0x00, 0x00, 0x00, 0x00, 0x00, 0x00, 0x00, 0x00,
0x00, 0x00, 0x00, 0x00, 0x00, 0x00, 0x00, 0x80, 0x80, 0x80, 0xC0, 0xC0, 0xC0, 0xC0, 0xC0, 0xC0,
0xC0, 0xC0, 0xC0, 0xC0, 0xC0, 0xC0, 0x80, 0x80, 0x80, 0x00, 0x00, 0x00, 0x00, 0x00, 0x00, 0x00,
0x00, 0x00, 0x00, 0x00, 0x00, 0x00, 0x00, 0x00, 0x00, 0x00, 0x00, 0x00, 0x00, 0x00, 0x00, 0x00,
0x00, 0x00, 0x00, 0x00, 0x00, 0x00, 0x00, 0x00, 0x00, 0x00, 0x00, 0x00, 0x00, 0x00, 0x00, 0x00,
0x00, 0x00, 0x00, 0x00, 0x00, 0x00, 0x00, 0x00, 0x00, 0x00, 0x00, 0x00, 0x00, 0x00, 0x00, 0x00,
0x00, 0x00, 0x00, 0x00, 0x00, 0x00, 0x00, 0x00, 0x00, 0x00, 0x00, 0x00, 0x00, 0x00, 0x00, 0x00,
0x00, 0x00, 0x00, 0x00, 0x00, 0x00, 0x00, 0x00, 0x00, 0x00, 0x00, 0x00, 0x00, 0x00, 0x00, 0x00,
0x00, 0x00, 0x00, 0x00, 0x00, 0x00, 0x00, 0x00, 0x00, 0x00, 0x00, 0x00, 0x80, 0xC0, 0xE0, 0xF0,
0xF8, 0xF8, 0xFC, 0xFE, 0xFE, 0xFF, 0x3F, 0x1F, 0x0F, 0x07, 0x07, 0x03, 0x03, 0x03, 0x03, 0x01,
0x01, 0x03, 0x03, 0x03, 0x03, 0x07, 0x07, 0x0F, 0x1F, 0x3F, 0x7F, 0xFE, 0xFE, 0xFC, 0xFC, 0xF8,
0xF0, 0xE0, 0xC0, 0x80, 0x00, 0x00, 0x00, 0x00, 0x00, 0x00, 0x00, 0x00, 0x00, 0x00, 0x00, 0x00,
0x00, 0x00, 0x00, 0x00, 0x00, 0x00, 0x00, 0x80, 0x80, 0xE0, 0xF0, 0x10, 0x18, 0x08, 0x08, 0x08,
0x18, 0x38, 0x70, 0xE0, 0xC0, 0x00, 0x00, 0x00, 0x00, 0x00, 0x00, 0x00, 0x00, 0x00, 0x00, 0x00,
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

	OzOled.init();  	//initialze Oscar OLED display

	OzOled.setInverseDisplay();          // Set Display to inverse mode
	OzOled.clearDisplay();               // clear the screen and set start position to top left corner
	OzOled.drawBitmap(OscarLogo, 0, 0, 16, 8);

}

void loop(){
  
}
