spenceraxani/Desktop-Muon-Detector/(commit log)

2016-11-11 Updated files
    [Light-tight top.ipt, Light-tight_box.ipt, Light-tight_box.stp, SMT_reference.xlsx]
2016-12-18 Updating supplementary material.
    [SMT_reference.xlsx]
2016-12-18 updating files
    [Light-tight top.ipt, Light-tight_box.ipt, Light-tight_box.stp, OLED_case.stp, box.stp, box_CNC.dxf, lid.stp]
2016-12-23 updating libraries
    [OLED_case.stp, Purchasing_list.xlsx, box.stp, box_CNC.dxf, lid.stp]
2017-07-13 replacing SiPM PCB files update
